mattmunee/Hardware-Designs/IntrusionNode_v2/IntrusionNode_v2.brd

## EAGLE design IntrusionNode_v2/IntrusionNode_v2.brd (2015-08-28)

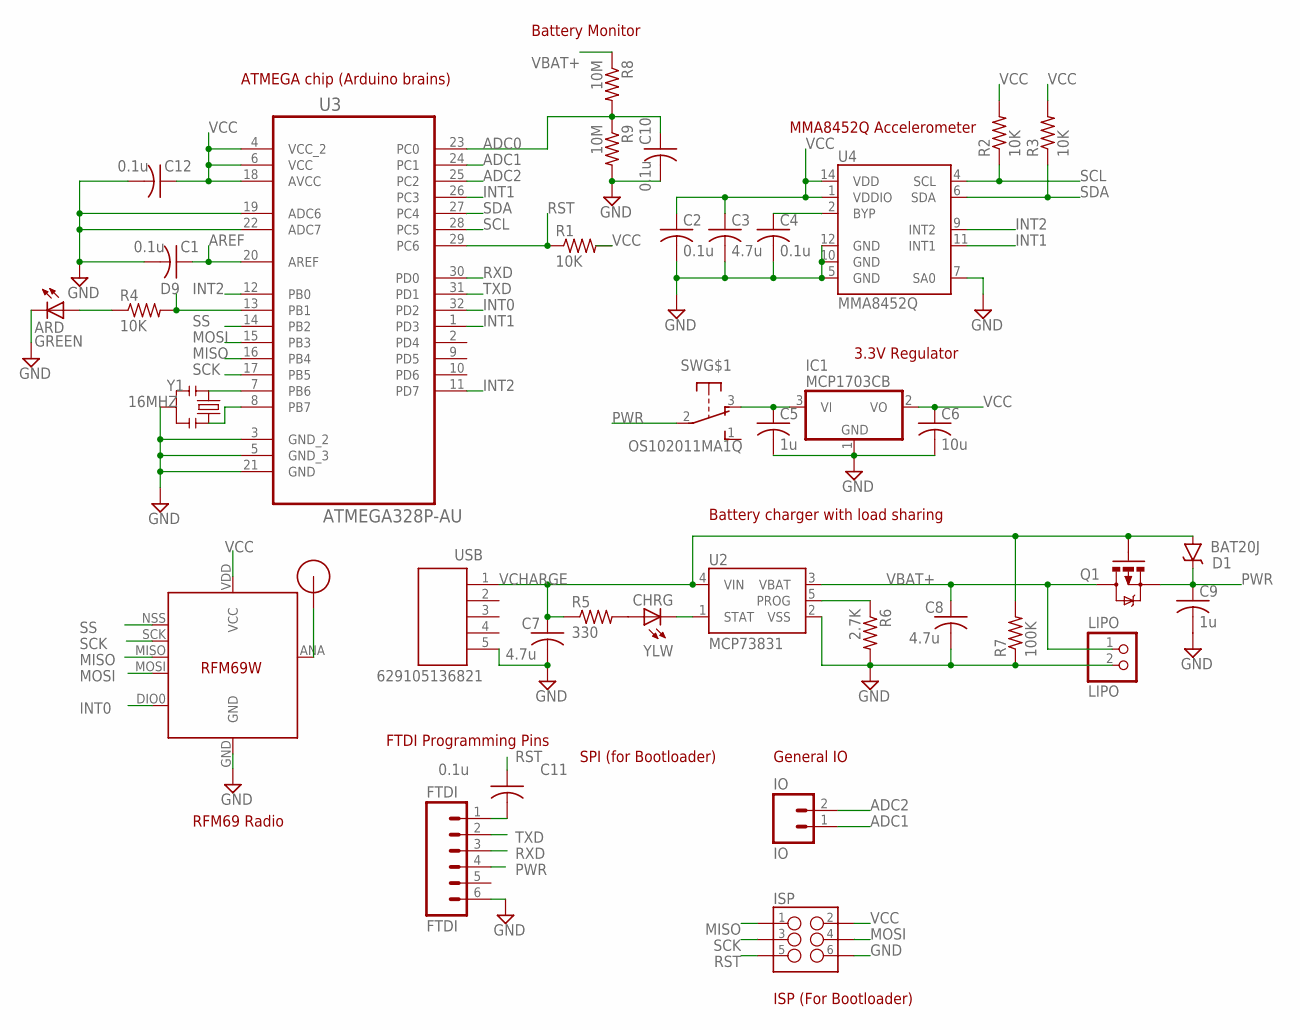
[picture p1: schematic IntrusionNode_v2.sch]

Parts:
ANT: RFM12B_ANTENNA; RFM12B-ANTENNA; PARTNO *
ARD: GREEN; CHIPLED_0805; PARTNO LG R971-KN-1
C1, C2, C4, C10, C11, C12: 0.1u; C0805; PARTNO CL21B104KBCNNNC
C3, C7, C8: 4.7u; C0805; PARTNO CL21A475KPFNNNE
C5, C9: 1u; C0805; PARTNO CL21B105KPFNNNE
C6: 10u; C0805; PARTNO CL21B106KPQNNNE
CHRG: YLW; CHIPLED_0805; PARTNO LY R976-PS-36
D1: BAT20J; SOD-323; PARTNO BAT20JFILM
FTDI: FTDI; 1X06_LOCK_LONGPADS; PARTNO 0022284363
IC1: MCP1703CB; SOT23; PARTNO MCP1703T-3302E/CB
IO: IO; 1X02_LOCK_LONGPADS; PARTNO 0022284363
ISP: M03X2NO_SILK; 2X3-NS; PARTNO 0010897060
LIPO: LIPO; JST-PH-2-SMT-RA; PARTNO S2B-PH-SM4-TB(LF)(SN)
Q1: MOSFET-PCHANNELSMD; SOT23-3; PARTNO PMV48XP,215
R1, R2, R3, R4: 10K; R0805; PARTNO RC2012J103CS
R5: 330; R0805; PARTNO RC2012J331CS
R6: 2.7K; R0805; PARTNO RC2012J272CS
R7: 100K; R0805; PARTNO RC2012J104CS
R8, R9: 10M; R0805; PARTNO RC2012F106CS
SW: OS102011MA1Q; PARTNO OS102011MA1QN1
U1: RFM69; RFM69W-MINPADS; PARTNO RFM69W
U2: MCP73831; SOT23-5; PARTNO MCP73831T-2ATI/OT
U3: ATMEGA328P-AU; QFP80P900X900X120-32N; PARTNO ATMEGA328P-AUR
U4: MMA8452Q; QFN-16_0.5MM; PARTNO MMA8452QT
USB: 629105136821; PARTNO 629105136821
Y1: 16MHZ; X3-SMD-3.6X1.3X0.8MM; PARTNO CSTCE16M0V53-R0

Connections:
ADC0: C10.1, R8.2, R9.1, U3.23 (PC0)
ADC1: IO.1, U3.24 (PC1)
ADC2: IO.2, U3.25 (PC2)
AREF: C1.1, U3.20 (AREF)
D9: R4.2, U3.13 (PB1)
GND: ARD.C, C1.2, C2.2, C3.2, C4.2, C5.2, C6.2, C7.2, C8.2, C9.2, C10.2, C12.2, FTDI.6, IC1.1 (GND), ISP.6, LIPO.2 (1), R6.2, R7.1, R9.2, U1.GND, U2.2 (VSS), U3.3 (GND_2), U3.5 (GND_3), U3.19 (ADC6), U3.21 (GND), U3.22 (ADC7), U4.5 (GND), U4.7 (SA0), U4.10 (GND), U4.12 (GND), USB.5, Y1.2
INT0: U1.DIO0, U3.32 (PD2)
INT1: U3.1 (PD3), U3.26 (PC3), U4.11 (INT1)
INT2: U3.11 (PD7), U3.12 (PB0), U4.9 (INT2)
MISO: ISP.1, U1.MISO, U3.16 (PB4)
MOSI: ISP.4, U1.MOSI, U3.15 (PB3)
unnamed: U3.7 (PB6), Y1.1
unnamed: U3.8 (PB7), Y1.3
unnamed: C4.1, U4.2 (BYP)
unnamed: ANT.P$1, U1.ANA (ANT)
unnamed: ARD.A, R4.1
unnamed: R6.1, U2.5 (PROG)
unnamed: CHRG.C, U2.1 (STAT)
unnamed: CHRG.A, R5.2
unnamed: C11.2, FTDI.1
unnamed: C5.1, IC1.3 (VI), SW.3 (O)
PWR: C9.1, D1.C, FTDI.4, Q1.2 (S), SW.2
RST: C11.1, ISP.5, R1.1, U3.29 (PC6)
RXD: FTDI.3, U3.30 (PD0)
SCK: ISP.3, U1.SCK, U3.17 (PB5)
SCL: R2.1, U3.28 (PC5), U4.4 (SCL)
SDA: R3.1, U3.27 (PC4), U4.6 (SDA)
SS: U1.NSS (SEL), U3.14 (PB2)
TXD: FTDI.2, U3.31 (PD1)
VBAT+: C8.1, LIPO.1 (2), Q1.3 (D), R8.1, U2.3 (VBAT)
VCC: C2.1, C3.1, C6.1, C12.1, IC1.2 (VO), ISP.2, R1.2, R2.2, R3.2, U1.VDD (VCC), U3.4 (VCC_2), U3.6 (VCC), U3.18 (AVCC), U4.1 (VDDIO), U4.14 (VDD)
VCHARGE: C7.1, D1.A, Q1.1 (G), R5.1, R7.2, U2.4 (VIN), USB.1

Notes on the sheet:
Battery Monitor
ATMEGA chip (Arduino brains)
RFM69 Radio
Battery charger with load sharing
FTDI Programming Pins
SPI (for Bootloader)
General IO
3.3V Regulator
MMA8452Q Accelerometer
ISP (For Bootloader)

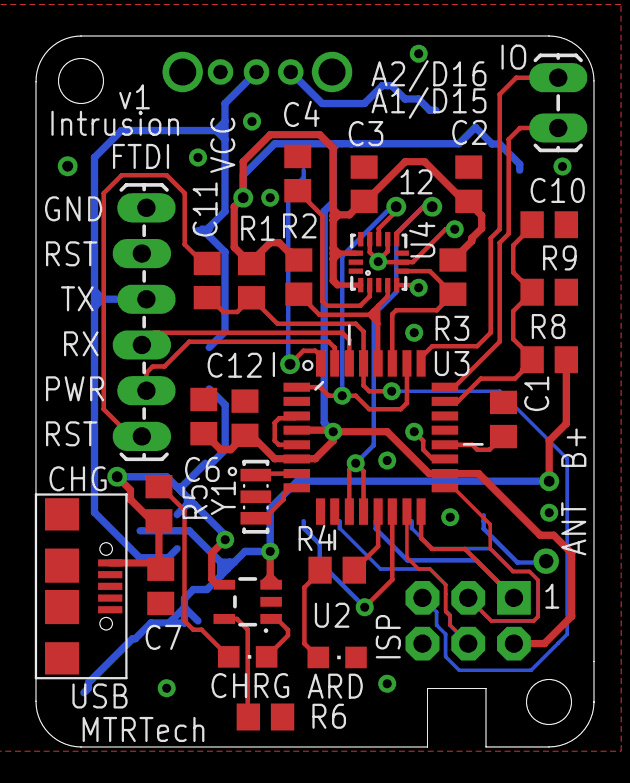
[picture p2: board IntrusionNode_v2.brd from above]

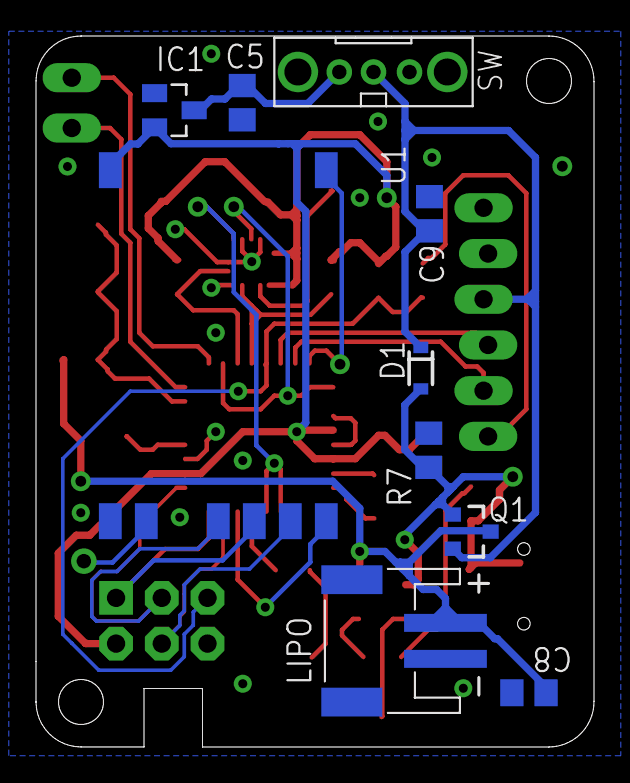
[picture p3: board IntrusionNode_v2.brd from below]

Board: 2 copper layers, 31.0 x 39.5 mm, 38 parts (10 on the bottom side), 32 nets.
