mattmunee/Hardware-Designs/(commit log)

2015-08-18 Commit current IntrusionNode design
    [IntrusionNode_v2.brd, IntrusionNode_v2.sch]
2015-08-24 First commit of intrusion node
    [IntrusionNode_v2.brd, IntrusionNode_v2.sch]
2015-08-25 *** Parts order place on Digikey
    Web ID 149351856 Access ID 51215 Salesorder Number 43979223 Submitted 8/25/2015 4:06:46 PM
    Modified board, adding notch, also changed part numbers for diode
    and MOSFET to reduce current.
    [IntrusionNode_v2.brd, IntrusionNode_v2.sch]
2015-08-28 ** Place OSH Park Order Number Er6KsneG, project name IntrusionNode_v2_150827
    [IntrusionNode_v2.brd]
